reazon-research/OpenArm/(threads)

Thread 2 (2024-09-26):

Establish a policy as an OSS project

daijiro, 2024-09-26:
- 想定ユーザ
  - 研究用途〜軽作業での実用
  - 低コストで実用的な協働ロボットアームを使いたい
  - バイラテ制御を使いたい
  - テレオペで使いたい
  - 良質なデータを収集したい
  - 好きな部品を使って自由にカスタマイズしたい
- 提供機能範囲
  - バイラテラル制御
  - マルチカメラテレオペレーション
  - 7dof リーダ・フォロワアーム
  - 汎用グリッパ
  - リーダマニピュレータ
- 論点
  - リスクアセスメントどこまでやるか (ISO/TS15066)
  - バイラテを前提とするのか
  - 作業空間バイラテもやるのか
  - VRサポートするか
  - dynamixelとbrushless両方サポートするのか
  - ネットワーク帯域・遅延どこまで想定するか
  - ペイロード目標をどう設定するか
  - ROS前提とするか
  - 市販のパーツをそのまま使うかどうか

Closed 2025-02-20.

Thread 16 (2025-01-21):

CAN FD + Damiao Motors

daijiro, 2025-01-21:
The combination of CANable, CAN FD, and SocketCAN is not working properly.
When I specify `fd on`, the following message appears and the operation fails.

```sh
sudo ip link set can0 type can bitrate 1000000 fd on
RTNETLINK answers: Operation not supported
```

edwin-giang, 2025-02-27:
Closing this issue -- CANable works with DAMIAO motors

Closed 2025-02-27.

Thread 17 (2025-01-23):

Open Arm Release Updates

edwin-giang, 2025-01-23:
**Overview**
---
This issue serves as a major tracker for the development and completion of Open Arm up until the release date. The thread will continue to be updated until the first release of Open Arm.

Important Dates + Items
---
**Feb 10:** Career Fair Ship Out Date
**Feb 14:** Internal OpenArm Deadline for 1st Release
**Feb 19:** Study Group Event Date

**Major Tasks**
---
General Tasks:
- [x] ReadMe
  - Pending Edit
- [x] Landing Page
  - Pending Edit
- [x] BOM Translation
  - Merge Appendix (Pedestal) w/ Main BOM
- [x] Assembly Guide Overview
  - Waiting for Motor Assembly Steps
- [x] GitHub
  - Populate
- [x] Media Materials
  - Photos Monday, need renders
- [x] Feedback/Contact Form
  - Need hi_public@reazon.jp to update notifications
- [x] Futures Page (Things to work on next)
- [x] OpenArm Discord
  - Pending Feedback
- [x] OpenArm Pedestal Design
  - Assemble on Tuesday

@pruthakjoshi:
- [x] End Effector
  - Waiting on more parts
- [x] CAD Materials

@1lokeshpatel:
- [x] CAN FD troubleshooting
  - Create issue on GitHub
- [x] Arm Control Program
- [x] GitHub Organization

@Ravoik:
- [x] Genesis simulation control + examples
  - Create demo/tutorial
- [x] URDF validation
  - Upload final URDF version to GitHub (check w/ Edwin)

@Hiroki-HANAMORI:
- [x] Risk Assessment Guideline
- [x] Media Materials (Key Visual)
- [x] Licensing

Closed 2025-02-21.

Thread 20 (2025-01-24):

Damiao Motor Driver Soldering + Troubleshoot

edwin-giang, 2025-01-24:
Issue for tracking fix for Damiao motor driver board connector. Working on testing different methods to solder CAN connector to the board to prevent shorting.

Closed 2025-02-20.

Thread 21 (2025-01-24):

Basic Arm Motor Control Example

1lokeshpatel, 2025-01-24:
**Goal**: To create a motor control example/test that can be included as part of OpenArm first release that takes URDF joint limits for all motors and moves to given pose.

Closed 2025-02-20.

Thread 26 (2025-01-24):

BOM Clean Up

edwin-giang, 2025-01-24:
Issue for BOM/Purchasing List regarding OpenArm V1

Closed 2025-02-20.

Thread 31 (2025-01-27):

1st Release Lessons Learned Items

edwin-giang, 2025-01-27:
Thread for tracking items for improvement post 1st release OpenArm

edwin-giang, 2025-02-19:
Wire Harness Fixes
---
- Replace all harnesses that use alternative routing methods
- Universalize connector manufacturing process (same length, same input/output, solder to top/side of pin, hot glue)
- Fix 3D printed parts to route parts with interference
- Path plan wire harness for modified mechanical parts

edwin-giang, 2025-02-19:
Mechanical Fixes
---
- Make left arm components
- Fix joint limits for left arm assembly
- Reinforce wrist to EE attachment strategy
- Change EE (make non-ARX)
- Make wrist smaller (?)

edwin-giang, 2025-02-19:
Software
---
- Gravity compensation direction
- CAN FD

edwin-giang, 2025-02-25:
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

Closed 2025-02-20.

Thread 34 (2025-02-03):

Maximize Control Frequency

daijiro, 2025-02-03:
One of the key performance indicators for a robotic arm is its control frequency.
The higher the control frequency, the more accurately you can estimate the reaction force on the robot arm by comparing each motor’s current value and encoder value against the dynamics model.
This is not only important for balancing operability and reproducibility in bilateral control,
but also essential for ensuring that the robot arm can perform tasks robustly and safely in systems with significant disturbances.

The ALOHA robot arm, which uses Dynamixel motors, can be controlled at a frequency of around 500Hz.

In the document 固件更新日志-3.0.pdf (Firmware Update Log) for the Damiao motors used in OpenArm, there is a statement as follows:

    According to actual measurements, it is possible to efficiently control nine motors at 5Mbps at a control frequency of 1kHz, with no observed frame loss.

Because of this, we have been aiming for operation via CAN FD, which supports 5Mbps communication.

By using the CAN FD Extended HAT for Raspberry Pi, we confirmed that the system works with socketcan + CAN FD.
Furthermore, by updating the baudrate parameter in the motor firmware, I confirmed operation with a dbitrate set to 5M.
(However, because the motor flash memory has a limited number of rewrites, frequent parameter updates should be avoided.)
https://github.com/reazon-research/triad/blob/master/x/202501-socketcan/change_baudrate.py

However, I found that simply raising the dbitrate from 1M to 5M does not improve the control frequency.
One possible reason is that the payload length for communication messages remains 8 bytes for both sending and receiving,
so merely increasing the dbitrate may not have any effect.

The 固件更新日志-3.0.pdf describes a “one control four” mode that controls four motors simultaneously with a single message, but I was unable to confirm its operation.
(Maybe v41 firmware are not provided yet?)

Currently, our seven-axis arm can only achieve a control frequency of about 250Hz, which is inferior to ALOHA.

I implemented a simple hack to increase the control frequency without using CAN FD’s features.
Right now, we repeatedly transmit and receive data for each individual motor like this,

```python
        for motor in follower.motors:
            follower.control.controlMIT2(motor, Kp, Kd, pos, vel, tau)
            follower.control.recv()
```

I changed this to send control messages to all motors, then subsequently receive the return values from all motors like this.

```python
        for motor in follower.motors:
            follower.control.controlMIT2(motor, Kp, Kd, pos, vel, tau)
        for motor in follower.motors:
            follower.control.recv()
```

This alone increased the control frequency from 250Hz to about 450Hz. However, it is merely a workaround.

Ultimately, we want to achieve a control frequency of 1kHz.

edwin-giang, 2025-02-27:
Waiting ESP32 to arrive 03-04 -- 03-07

edwin-giang, 2025-02-28:
ESP32 arrived today -- will reopen investigation

1lokeshpatel, 2025-03-05:
received mini CAN module, will attempt to run OpenArm using m5stack mini CAN and m5stack AtomS3

1lokeshpatel, 2025-03-06:
## 03/06 Update

- Did initial test of AtomS3 and currently testing example code to connect mini CAN module with AtomS3
-  Future implementation seems like it will require replacing SocketCAN interface with MCP2517FD interface (or something similar, need to do more research), and then I will be able to test mini CAN module with OpenArm

1lokeshpatel, 2025-03-18:
## 03/18 Update

STM32 DAMIAO development board arrived yesterday. Started development with it.

**Current Progress:**
- DAMIAO uses the Keil tools developed by ARM for their dev examples so I started by setting that up. Keil is a set of development tools that includes compilers, debuggers, IDE (uVision), and more to help with embedded systems development.
- After setting up Keil and uVision (Keil development IDE), I cloned a DAMIAO example (https://github.com/dmBots/DM_Stm32_Example/tree/main/CtrlBoard-H7_4310), for controlling one motor at baudrate of 1 Mbps.
- Right now the [canfd branch](https://github.com/reazon-research/OpenArm/tree/canfd) for the OpenArm repo has code that controls one DM4310 motor. I am working on a openarm control library that controls multiple motors and will follow up on the results of that test.

edwin-giang, 2025-03-21:
Moving issue to vFuture

1lokeshpatel, 2025-03-25:
03/25 Update
---

Currently have a version of STM32 Motor Control working that controls all 7 motors. Now I want to add safety checks, add 8th end effector motor and start testing with OpenArm afterwards.

**Blockers:** The NUCLEO-F446RE board I was using as a ST-Link debugger is shorted so I need to buy a new board from the nearby stores to continue debugging and testing with DAMIAO development board.

edwin-giang, 2025-04-04:
Moving issue to v1.0

1lokeshpatel, 2025-04-10:
04/10 Update
---

**Main updates:**
- 7 motor maximum control frequency with 1MBps CAN communication with STM32 determined to be approximately 1kHz. With this control frequency, I was able to send movement commands to all motors and recieve a feedback message without any collisions and faults.
- Created a program that slowly increased torque and used it to collect data and create loop number vs velocity plot to show smooth increase in velocity.

1lokeshpatel, 2025-04-11:
04/11 Update
---
- Added velocity, position, and torque limits for DM4340 motor.
- Tested control frequency. Approximate maximum control frequency with 1Mbps STM32 control for:
  - 6 motors: 1.175kHz
  - 7 motors: 1kHz
  - 8 motors: 950Hz

Measurement metric for control frequency was to ensure that control and feedback messages were sent back and forth alternately. (if too many control messages were sent before feedback message was recieved, it would be considered too fast). Also, if the control loop timed out, that was also an indicator for a control speed that was too fast.

Seems like increasing motors does result a lower control frequency. NOTE FOR FUTURE: could be worth implementing a synchronization method for control and feedback loop to ensure that they always occur alternately, leading to more accurate control loop measurement.

Future:
- Change baudrate of motors to 5Mbps and test control frequency
- Clean up code and add safety limits
- Create commented code and detailed documentation

1lokeshpatel, 2025-04-15:
**04/15 Update**
---
- Changed all motors to 5 Mbps baudrate
- Max control frequency for 8 motors is approximately 2kHz with 5Mbps control

Same measurement metric, checking for 8 feedback messages every control loop and if there are less or if the loop timeouts, than I am assuming the control loop is running too fast.

Future:
- Update feedback messages to work with all IDs
- Currently using python script to change baudrate, working on changing baudrate using C function through STM
- Documenting progess

thomasonzhou, 2025-05-08:
CANFD STM32 code merged to main in v0.3, closing

Closed 2025-05-08.

Thread 35 (2025-02-05):

Gravity Compensation in OpenArm

hisashi-ito, 2025-02-05:
###  Motivation
OpenArm のURDFを利用することで[kdl](https://wiki.ros.org/kdl)を使って重力補償に必要な各軸のトルクが計算できる。このトルクをgenesis上でOpenArmの各軸に入力したときに、任意のポーズで静止できるかチェックする。

By using the OpenArm URDF, it is possible to calculate the torque required for gravity compensation on each axis using [kdl](https://wiki.ros.org/kdl). When this torque is input to the OpenArm axes on Genesis, it can be checked whether the arm can remain stationary in a given pose.

Closed 2025-07-23.

Thread 36 (2025-02-06):

Fork fusion2urdf to generate ros2-friendly urdf packages

thomasonzhou, 2025-02-06:
[https://github.com/syuntoku14/fusion2urdf](https://github.com/syuntoku14/fusion2urdf)
MIT license

Currently, some components are outdated:
- ALL launch files
- generated urdf (e.g. robot tag is missing name property)
- output *.obj instead of *.stl meshes

Closed 2025-02-25.

Thread 41 (2025-02-21):

Post v0.01 Release -- Electronics

edwin-giang, 2025-02-21:
Action Items for electronics improvement post release v0.1

edwin-giang, 2025-02-21:
Post v0.1 Release Action Items
---
- Add wire harness space under 3D printed covers
- Hide more wire harnesses (2 exposed max)
- Redesign w/ new connector locations in mind
- Respec cable and connectors (w/ solder joints)

Thread 42 (2025-02-21):

OpenArm Pedestal Improvements

edwin-giang, 2025-02-21:
Action Items for pedestal improvement post v0.1 release

edwin-giang, 2025-02-21:
Post v0.1 Release Action Items
---
- Change arm adapter CNC piece to M6
- Reduce shoulder width
- Increase height of pedestal by 50mm (to accommodate inspire hand) or can reduce arm length
- Add 45 degree extrusion as truss support for base
- Change 2x 30x60 to 1x 60x60
- Add housing for power brick, CANable, other electronics

edwin-giang, 2025-03-05:
03/05 Update Items
---
Updated pedestal design for v0.2 according to the list highlighted above. Below is the new design and the changes that are reflected:
- Arm Joint w/ M6 Clearance Hole
- Shoulder Width reduced to 43.6cm
- Increased height by 60mm
- Added 60degree extrusion
- Changed to single 60x60 extrusion trunk piece
- Reduced size of base plate
- Added housing area for electronics
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

edwin-giang, 2025-03-05:
Purchasing
---
Recalculated BOM for pedestal, reduction in price by 13000yen
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

edwin-giang, 2025-03-06:
Purchased, waiting for parts to arrive next week for assembly

edwin-giang, 2025-03-11:
03/11
---
Parts arrived today excluding base plate. Assembled majority, waiting on base plate arriving 03/13

edwin-giang, 2025-03-18:
03/18
---
All parts arrived, pedestal fully asssembled

Closed 2025-03-18.

Thread 43 (2025-02-21):

Post v0.1 Release -- Wrist Mechanism

edwin-giang, 2025-02-21:
Actions Items for wrist mechanism improvement post v0.1 release

edwin-giang, 2025-02-21:
Post v0.1 Release Action Items
---
- Order CNC components for temporal washer
- Increase the strength of the wrist linkages
- Increase strength of wrist frame
- Evaluate whether wrist assembly needs to decrease in length or width
- Investigate other wrist designs (rotary actuator, linear actuator, pulley actuator)

Thread 44 (2025-02-21):

Post v0.1 Release -- General Items

edwin-giang, 2025-02-21:
Action items for general items post v0.1 release

edwin-giang, 2025-02-21:
Post v0.1 Release Action Items
---
- Make dedicated arm for left arm use (differentiate from right arm)
- Add power switch + E-stop
- Re-evaluate risk factors of v0.1
- Add mechanical stop for elbow mechanism
- Update website, discord, github
- Work on dedicated leader arm

Thread 45 (2025-02-21):

Post v0.1 Release -- Software Items

edwin-giang, 2025-02-21:
Action items for software improvement post v0.1 release

edwin-giang, 2025-02-21:
Post v0.1 Release Action Items
---
**Simulation + URDF:**
- Update how left + right jaw joints are defined in simulation
- Fix base position
- Generate URDF for Pedestal
- Define force actuated limits
- Define inertia and mass of joints
- Create a better URDF w/ simplified geometry and no fasteners
- Define self-collision
- Create URDF w/ 5DOF EE attachment
- Create simple script to swap in different EEs
- Create more examples for simulation (IL, RL)

**Controls:**
- Clean up unilateral + bilateral code (add to github)
- Fix gravity compensation
- Remove jitter on CAN FD
- Merge control code onto 1 PC (unite left and right arm code)
- Define MIT Control
- Create ROS2 control library

Thread 46 (2025-02-21):

URDF CAD Simplification

edwin-giang, 2025-02-21:
Working on simplify CAD to help with meshes and reduce solve time

thomasonzhou, 2025-02-26:
Defining bounding boxes with RobotCAD and using the original meshes as visual representations only should speed up our sims:

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

thomasonzhou, 2025-03-10:
The addition of the dual gripper arm urdf in [openarm_ros2](https://github.com/reazon-research/openarm_ros2) is completed, closing issue

Closed 2025-03-10.

Thread 49 (2025-02-25):

Wire Harness Improvements

edwin-giang, 2025-02-25:
**Action Items for Wire Harness Improvements:**
- [x] Hide more wire harnesses (2 exposed max) (reduced as much as was reasonable)
- [x] Measure and plan remaining harness lengths in arm
- [x] Ask @NaohiroIIDA about manufacturing and order the cables

edwin-giang, 2025-02-28:
Measured and routed wire harnessing plan. Creating drawing to plan out cable splices and lengths:
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

edwin-giang, 2025-03-05:
02/27 Updates
---
Backlogged documentation from internal discussions:
Looked into LCSC for cable manufacturing, submitted quote for spliced cable design based off below drawing

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

edwin-giang, 2025-03-05:
02/28
---
Backlogged documentation from internal discussions:
Received quote for cables, cables are $2.99 per

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

edwin-giang, 2025-03-06:
03/06
---
Tested hand-soldered cables length -- remeasured cable C and need to fix cable B to have another splice
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

edwin-giang, 2025-03-10:
03/07
---
Reordered 12 new sets of cables from LCSC electronics according to new cable length. Won't arrive for v0.2 demo, will need to make 5 sets of new cables for demo arms -- asking @necobit for assistance.

edwin-giang, 2025-03-18:
03/17
---
- Issue with JST connector breaking. Asking @NaohiroIIDA to manufacture replacement cables temporarily.
- LCSC cables C and D arrived. Assessing quality versus hand manufactured cables. Gauge is much smaller on the LCSC cables compared to hand manufactured cables, but solder joint is more robust.

edwin-giang, 2025-03-18:
03/18
---
New batch of JST connectors arrived -- some cable length is slightly short due to manufacturer error. Will reorder and respec to account for manufacture tolerance. Closing issue for v0.2

Closed 2025-03-18.

Thread 50 (2025-02-25):

OpenArm Connector Improvements

edwin-giang, 2025-02-25:
**Action Items for Connector Improvements:**
- [x] Respec cable and male connectors (w/ solder joints)
- [x] Order motors with pre-soldered female connectors

hiroyams, 2025-02-27:
Talked with Kawazu-san
Mtg: Ryan, Hanamori-san, Kawazu-san
- investigate LCSC componenets

edwin-giang, 2025-03-05:
03/05 Updates
---
Issue is partially merged with #49 -- progress with LCSC is documented there

edwin-giang, 2025-03-18:
03/17
---
Issue is colliding with #75, closing issue as duplicate.

Closed 2025-03-18.

Thread 51 (2025-02-25):

OpenArm Wrist Mechanism Improvements

edwin-giang, 2025-02-25:
**Action Items for Wrist Mechanism Improvements:**
- [x] Increase the strength of the wrist linkages (p1)
  - [x] quick eval, see if changing material is enough
- [x] Order CNC components for temporal washer
- [x] Increase strength of wrist frame

edwin-giang, 2025-03-10:
03/07
---
FEA comparison between materials by Hanamori-san:
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

Above image is Aluminum, below is SS400. Shows roughly 1/3 the deformation -- may still need part redesign since forces exerted are much larger than simulated.

edwin-giang, 2025-03-18:
03/16
---
Order for SS parts arrived and assembled onto new arm. Will evaluate strength and reassess for next version. Closing issue for v0.2.

Closed 2025-03-18.

Thread 52 (2025-02-25):

Future Wrist Mechanism Items

edwin-giang, 2025-02-25:
**Future Wrist Mechanism Action Items:**
- [ ] Evaluate whether wrist assembly needs to decrease in length or width
- [ ] Investigate other wrist designs (rotary actuator, linear actuator, pulley actuator)

Thread 53 (2025-02-25):

OpenArm End Effector Improvements

edwin-giang, 2025-02-25:
**Action Items for End Effector Improvements:**
- [x] Reconduct risk assessment for the wrist
- [x] Change gripper claw design
- [x] Add backdrivability to claw (less friction)

hiroyams, 2025-02-27:
low priority, minimal fix:
- safety and wrist

Ravoik, 2025-03-06:
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

Finalized for v0.2, printing to test

Ravoik, 2025-03-06:
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

edwin-giang, 2025-03-18:
03/17
---
Breaking leader controller into separate sub-issue. For backdrivability, increased tolerance between bridge and rail -- using silicone spray to reduce friction of parts. End effector redesign is complete for v0.2, closing issue.

Closed 2025-03-18.

Thread 55 (2025-02-25):

OpenArm Simulation + URDF Improvements

edwin-giang, 2025-02-25:
**Action Items for Sim + URDF Improvements:**
- [x] Generate URDF for Pedestal 2.0
- [x] Create a better URDF w/ simplified geometry and no fasteners
- [x] Update how left + right jaw joints are defined in simulation
- [x] Fix base position
- [x] Edwin creating rigid groups in CAD with bodies to simplify geometry and export unified meshes for joints.
- [x] Once rigid groups are done we need to make a LHS flipped version of the arm to generate a urdf
- [x] need to swap the base of the open arm in cad to the pedestal base so that the urdfs can properly merge on the software side

1lokeshpatel, 2025-02-25:
URDF R/L Joint DOF Comparison:

- **joint 1**: same
- **joint 2**: mirror
- **joint 3**: mirror
- **joint 4**: same
- **joint 5**: mirror
- **joint 6**: same
- **joint 7**: mirror

edwin-giang, 2025-03-05:
03/05 Updates
---
- Generated URDF + mesh for pedestal
- Simplified URDF w/o fasteners, no rack on jaw joints
- Used RobotCAD to make conservative blocks for collision
- Used mimic to link left and right jaw

edwin-giang, 2025-03-05:
Need to merge pedestal v0.2 mesh and openarm mesh

Ravoik, 2025-03-05:
Edwin creating rigid groups in CAD with bodies to simplify geometry and export unified meshes for joints.

edwin-giang, 2025-03-06:
Waiting on left arm CAD from @Hiroki-HANAMORI before creating URDF export version

edwin-giang, 2025-03-10:
03/08
---
Created left arm CAD based off the assembly given by Hanamori-san. Closing issue since all CAD improvements for URDF v0.2 are completed

Closed 2025-03-10.

Thread 56 (2025-02-25):

OpenArm Controls Improvements

edwin-giang, 2025-02-25:
**Action Items for Controls Improvements:**
- [x] Merge control code onto 1 PC (unite left and right arm code)

edwin-giang, 2025-03-18:
03/18
---
Not merging until we receive new STM with more ports (current setup does not have enough ports for both arms)

edwin-giang, 2025-03-21:
Moving issue to vFuture

edwin-giang, 2025-04-04:
Closing issue under v1.0, teleop control code merged into one device

Closed 2025-04-04.

Thread 58 (2025-02-25):

OpenArm Safety Improvements

edwin-giang, 2025-02-25:
**Action Items for OpenArm Safety Improvements:**
- [ ] Add **power switch** and add to BOM-- HIGH PRIORITY
- [x] Re-evaluate risk factors of v0.1

edwin-giang, 2025-03-21:
Moving issue to vFuture

Closed 2025-07-23.

Thread 59 (2025-02-25):

Left Arm Design

edwin-giang, 2025-02-25:
**Action Items:**
- [x] Adapt mechanical design for left OpenArm

Ravoik, 2025-03-05:
- Ordered some flipped parts for Open Arm left arm
- @Hiroki-HANAMORI need to discuss the shoulder joint parts, need to flip and order LHS versions of these parts because the limits are different from the right.

edwin-giang, 2025-03-06:
03/06
---
Determined plan to create left and right arm using mainly pre-existing parts. Left arm joint 2 will have bearing located at front, right arm will have bearing at back. For both arms, follow the guide below for assembly:
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

edwin-giang, 2025-04-04:
03/19
---
Completed reassembly of OpenArm for left arm. Ordered mirrored sheet metal parts for left wrist and assembled. Closing issue under v0.2, will iterate in future versions

Closed 2025-04-04.

Thread 61 (2025-02-26):

Specification Sheet

edwin-giang, 2025-02-26:
**Action Items:**
- [x] Measure Capacity of OpenArm
- [x] Create spec sheet to put on the website

hiroyams, 2025-02-27:
list out what specs we want to measure, consider work load

edwin-giang, 2025-03-21:
Moving to vFuture, unblocking issue

edwin-giang, 2025-04-04:
closing issue under v0.2, spec sheet on github and website

Closed 2025-04-04.

Thread 62 (2025-02-27):

Redesign OpenArm

hiroyams, 2025-02-27:
- [ ] consider cabling (camera, hand, sensors, etc.)

Closed 2025-07-23.

Thread 63 (2025-02-28):

Strengthen wrist to hand attachment method

edwin-giang, 2025-02-28:
Strengthening linkage for end effector to arm attachment

edwin-giang, 2025-02-28:
Assigned Lokesh to issue

1lokeshpatel, 2025-02-28:
finished first draft of design, located in Fusion360. ReazonResearch --> Triad --> Data_by_LOKESH --> EndEffector_WristRedesign

**Changes to make:**
- add counter sink for screws into motor (reducing size of that plate
- shorten link as much as possible

1lokeshpatel, 2025-03-05:
## 03/05 Update

- added countersunk holes for both plates
- added fillets to smoothen design
- reduced plate size and link length size
- changed to cap design instead of small juts for hardstop

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

1lokeshpatel, 2025-03-06:
## 03/06 Update

- Printed first design

**Issues:**
- the 4th attachment hole for end effector motor cannot be blocked by linkage as it is needed to strengthen and ensure it doesn't snap
- slight tolerancing changes needed for countersinks and cap design to ensure there are no collisions with fasteners
- more feature fillets

**Fixes:**
- create the feature fillets
- widen the linkage as much as possible and create fillets where possible for stress distribution

1lokeshpatel, 2025-03-10:
## 03/10 Update

Tested with feature fillets and 4th hole addition. Works okay but need larger opening for that screw to be inserted in a more smooth manner. Also printing in a different orientation helps with overall print quality.

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

**Changes:**
- larger opening for that screw hole, increase overall diameter of pipe extrude cut but also expand horizontally out of the plate.

1lokeshpatel, 2025-03-11:
**Final Iteration, will reopen if testing reveals flaws:**

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

Closed 2025-03-11.

Thread 64 (2025-02-28):

Define inertia and mass of joints

edwin-giang, 2025-02-28:
Physical testing of inertia and mass of joints

edwin-giang, 2025-03-04:
03/04 Meeting:
---
- Currently testing one arm for inertia values
  - Had issue with baudrate, now reset so testing can continue

thomasonzhou, 2025-03-04:
Test code available at: https://github.com/reazon-research/inertia-test
The baud rate update python script is reset after power cycling, so we should opt to flash permanently when possible (@1lokeshpatel do we have another open issue already?)

edwin-giang, 2025-03-06:
Waiting to test 4340P motors, blocked since motors have not been assembled -- devising new test plan

edwin-giang, 2025-03-11:
03/11
---
Opened issue #78 for 4340P motors, closing this issue now as all inertia testing for 4340 is complete.

thomasonzhou, 2025-03-12:
Masses (kg)
1. 0.486
2. 0.178
3. 0.404
4. 1.123
5. 0.558
6. 0.470
7. 0.346
8. 0.298

*Link 1 did not include the the mounting components:

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

Closed 2025-03-11.

Thread 65 (2025-02-28):

Motor Connector Soldering

edwin-giang, 2025-02-28:
Hotfix connectors by soldering 2x male connectors to each DAMIAO motor

edwin-giang, 2025-02-28:
Disassembling arm -- breaking into major linkages for Inertia Testing #64.
Noting down loose fasteners from demo day use.

Ravoik, 2025-02-28:
Lose Fasteners
--------------------
- Top four 30x60 nuts were pretty loose, did not need to use long side of m4 Allen key to remove them which is troubling because they were tightened with the long side. Hopefully resolved by using m6 nuts in the future.
- Horizontal Wrist Motor, 4 face mount screws loose enough to jiggle the entire motor.

Connector Soldering Updates
-------------------
- Unscrewed all caps
- Desoldered old leads
- Cleaned solder pads
- Unscrewed pcbs

edwin-giang, 2025-03-05:
03/05 Updates
---
Soldering new connectors for both arms complete
- Soldered 2 male CAN connectors to each motor
- Assembling arms back together

Ravoik, 2025-03-05:
- Arms reassembled, waiting on cables to power them on (eta minimum Thursday)

Closed 2025-03-05.

Thread 67 (2025-03-05):

Create URDF w/ EE attachment

edwin-giang, 2025-03-05:
Create method to attach different end effectors for URDF MuJuCo file
- For inspire hand, need to retain joint activation in URDF

thomasonzhou, 2025-03-17:
URDFs for openarm and openarm_bilateral are complete, closing

Closed 2025-03-17.

Thread 70 (2025-03-05):

Threadlocker/Screws loosening

Ravoik, 2025-03-05:
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

 _Originally posted by @Ravoik in [#65](https://github.com/reazon-research/OpenArm/issues/65#issuecomment-2689659791)_

edwin-giang, 2025-03-11:
03/11
---
Closing issue since key loctite locations have been identified

Closed 2025-03-11.

Thread 71 (2025-03-05):

Create Base plate for Inspire hand

Ravoik, 2025-03-05:
Create a 3d printable base-plate to mount the inspire hand to a table

edwin-giang, 2025-03-10:
03/07
---
Simple 3D printed base was created by tracker team, closing issue.

Ravoik, 2025-03-11:
@megan-spee if you could upload the file here please 🙏

edwin-giang, 2025-03-19:
03/19
---
Linking part files for inspire hand base:
[hand_mount.zip](https://github.com/user-attachments/files/19331872/hand_mount.zip)

Closing issue

Closed 2025-03-19.

Thread 72 (2025-03-05):

Build 2 more arms and add locktite to all arms

Ravoik, 2025-03-05:
Set up a meeting with Hanamori-san to figure out where the locktite will go
- [ ] assemble left arm
- [ ] assemble right arm
- [ ] locktite all arms

Ravoik, 2025-03-11:
Finished all motor cap replacements together on 3/10, edwin has been assembling and is 50% done both arms as of 3/11.
Made the decision to make two left arms instead of a left and right.

edwin-giang, 2025-03-11:
03/11
---
85% of arm is assembled, waiting on new wrist machined components to finish assembly.

edwin-giang, 2025-03-18:
03/17
---
Completed new arm assembly, ready to be mounted to pedestal

Thread 73 (2025-03-06):

investigate & compare motors

edwin-giang, 2025-03-06:

edwin-giang, 2025-03-06:
03/06 Updates
---
Conducted brief comparison and breakdown of specs of each motor
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

Inquired about purchasing, will create a PO later today to purchase and test motors

edwin-giang, 2025-04-04:
03/27
---

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

Compared wider variety of motors across greater ranges, purchased 8009 for investigation

Thread 75 (2025-03-06):

Redesign cover cutout locations with respect to new connector locations

edwin-giang, 2025-03-06:

edwin-giang, 2025-03-06:
03/06
---
Need to delegate who owns this issue

edwin-giang, 2025-03-11:
03/11
---
Designed new cover cutouts, printing to test

edwin-giang, 2025-03-18:
03/17
---
Redesign of cover cutouts complete for v0.2. Closing issue.

Closed 2025-03-18.

Thread 76 (2025-03-06):

Define MIT Control

edwin-giang, 2025-03-06:

edwin-giang, 2025-03-06:
Moved issue to vFuture

thomasonzhou, 2025-03-06:
Manual from the supplier: [MIT instructions (chinese).pdf](https://github.com/user-attachments/files/19101282/MIT.instructions.chinese.pdf)

Closed 2025-03-06.

Thread 77 (2025-03-06):

Create ROS2 control library

edwin-giang, 2025-03-06:

edwin-giang, 2025-03-06:
Moved issue to vFuture

thomasonzhou, 2025-03-06:
WIP on ros2_control branch:
https://github.com/reazon-research/openarm_ros2/tree/ros2_control

Subtasks:
- [x] define control interfaces
- [  ] complete hardware package (start with position control, then velocity, torque)
- [  ] create simple controller (PID)
- [  ] complete bringup package (1 command launch)

edwin-giang, 2025-04-04:
moving issue to v1.0

edwin-giang, 2025-04-10:
Video of ROS2 Control implementation

https://github.com/user-attachments/assets/f9a173ba-f2f1-4ecc-b61e-a9716bf19885

thomasonzhou, 2025-04-10:
Merged to main https://github.com/reazon-research/openarm_ros2/tree/main

Requesting a commit bump in the main repo @edwin-giang
- https://github.com/reazon-research/OpenArm/pull/92

Closed 2025-04-24.

Thread 78 (2025-03-06):

4340P CAD and URDF Adjustments

Ravoik, 2025-03-06:
We need to adjust the CAD caps that interface with the 4340P as well as re-measure the inertia values for the effected axis.
- [ ] 4340P CAD modified
- [ ] 4340P parts ordered
- [ ] 4340P mounted on arm and inertia measured

Hiroki-HANAMORI, 2025-03-14:
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
CAD updates have been completed to accommodate 4340P.
The general shape of the arm has changed little.

Left side of image: old arm
Right side of the image: arm with 4340P installed

Hiroki-HANAMORI, 2025-03-14:
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

The cross roller version of the DAMIAO gear head has been modified to a structure that holds the bearings in place.
Therefore, it was modified so that the cap for attaching the key can be assembled without disassembling.

J1 has already been assembled with Ory-san's arm, so no change is necessary.
J3 was modified to install the gear head without disassembling the gear head, reflecting the reflection on Ory-san's arm.

Hiroki-HANAMORI, 2025-03-14:
Preparation of order data has begun.
Inquiries are underway for J3 caps due to a processing error.

To avoid errors in the quotation, I am also preparing data with the error points removed, but this will reduce the strength of the part.
If the quotation takes time, we will proceed with the order.

edwin-giang, 2025-04-04:
04/03
---
Moving issue to v1.0. New parts for 4340P arrived and reassembly was completed. Will adjust and reorder parts as needed

Hiroki-HANAMORI, 2025-04-04:
Details of any problems identified in assembly and plans for revision

- Axis parts for symmetrical parts, length needs to be extended by 1,mm.
-- Perhaps the fact that the 4310 was made from the CAD of the 4340 had a negative effect.
-- Despite the different thickness of the TOP caps of 4340 and 4310, they were designed with the same dimensions, which caused the axis to sink 1mm...
-- In this case, we used a 1mm spacer
- The shaft part coming out of J1 needs to be extended by 3mm in length.
-- Purely an ordering error.
-- The old data was submitted.
-- This time, we used a 3mm spacer.
- Connector position of 4340P is not very good.
-- The connector position was subtle because the original hole on the top surface of the motor was used.
-- The base part could be handled by changing the slit position.
-- J3 may have to allow the connector to be tilted.

Thread 79 (2025-03-06):

Confirm rigid group URDF generation works in Onshape

Ravoik, 2025-03-06:
We have a rigid group assembly of our components in Fusion working and exporting to URDF & robotcad.
We need to check if this method works in Onshape because Fusion license will end by 03/10

edwin-giang, 2025-03-19:
03/19
---
Moving issue to vFuture

Closed 2025-07-23.

Thread 80 (2025-03-06):

Improvements to make the arm symmetrical

Hiroki-HANAMORI, 2025-03-06:
In order to position the arm in a humanoid shape, it is necessary to invert the assembly and invert the parts.

- [ ] Parts Mirror
- [ ] Adjustment of machine limits
- [ ] Mirroring of assemblies
- [ ] Adjustment of URDF

Closed 2025-03-06.

Thread 81 (2025-03-07):

Autocalibration on Startup

thomasonzhou, 2025-03-07:
There is currently a gap between CAD/URDF/MJCF joint parameters and the real joint parameters on real robots, namely:
- joint limits
- zero positions

To add an additional layer of reliability on top of the mechanical hard stops, it would make sense to add software stops. One way to do this would involve:
1. detecting the true joint limits on startup (gently move position command to ends until it does not change)
2. moving to a known offset (desired zero position)
3. set zero positions of motors

edwin-giang, 2025-03-18:
Moving to vFuture

edwin-giang, 2025-04-04:
Assigning issue to @Ravoik, moving issue to v1.0

Ravoik, 2025-04-14:
Measured joint limits and necessary offsets, converting to rads.
Figured out MIT control and how to use the library.
Wired spare open arm, setup with pedestal.
Finished 1st version of script, need to clean up and comment on code. Will post a video here.

Thread 82 (2025-03-18):

Redesign leader controller

edwin-giang, 2025-03-18:
Make minor adjustments to leader controller
- [x] fix grip shape and distance
- [ ] change pincher shape

edwin-giang, 2025-03-19:
03/19
---
Updated leader controller design, printing to test
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

edwin-giang, 2025-03-21:
03/19
---
Printed and tested, demoed for v0.2. Will work on reiterating design for next version. Moving issue to vFuture

edwin-giang, 2025-04-04:
moving issue to v1.0, need to adjust pinching mechanism

edwin-giang, 2025-04-18:
04/18
---
Updated Leader Controller design. Designed with the following criteria in mind:
- Improve ease of actuation
- Increase backdrivability
- Improve safety conditions from potential of rail or end effector components hitting user
- Design for machined components and 3D printed components

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

Printed and tested using heat set inserts, closing issue for this version

Closed 2025-04-18.

Thread 86 (2025-04-04):

Add mechanical stop for elbow mechanism

edwin-giang, 2025-04-04:
- [ ] Redesigning machined component to redefine ROM of elbow joint

edwin-giang, 2025-04-04:
Broke out issue from #58, assign self to task, moving to v1.0

edwin-giang, 2025-04-04:
04/04
---
Adjusted mechanical joint limit of elbow, reduced flexion by 10 degrees to avoid upperarm and forearm pinching condition that occurs when wrist is rotated. Reduced extension by 20 degrees to avoid elbow inversion condition.

Closed 2025-04-24.

Thread 87 (2025-04-04):

Payload Testing

edwin-giang, 2025-04-04:
*What is the pre-existing problem? Please describe.*
Need to properly evaluate payload capacity of OpenArm for spec sheet and future planning

*Describe the solution you'd like*
Testing increasing weights under standards conditions and worst case conditions

*Additional context*
End effector included in test. Using water weight.

*Next Steps*
- [ ] Conduct Payload Test

edwin-giang, 2025-04-04:
03/27
---
From 03/27, payload testing conducted and completed. Testing different ranges of weight using filled water bottle.

At standard payload (regular workspace), arms were capable of handling up to ~3kg not including the end effector. Arm did not trigger safety mechanism despite this load.

At worst case payload (furthest from COG), arms were capable of handling 1.6kg not including the end effector. Arm triggered safety mechanism at max reach point under this load.

Calculations were conducted to verify payload results. Screenshots are depicted below verifying results:

_For Worst Case:_
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
DAMIAO 4340 has a max torque of 27Nm -- matches the result from test

_For Standard Case:_
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
For standard case, calculations show arm is capable of 5.5kg payload. Since this was not tested in the payload, a conservative estimate of 3.5kg was used.

Closed 2025-04-04.

Thread 88 (2025-04-04):

Improved disassembly procedure for DAMIAO motors

Hiroki-HANAMORI, 2025-04-04:
Disassembly of DAMIAO motors, especially the removal of the 4340 BTM capsule, is difficult because thread lock is applied to the M2 countersunk screws, which sometimes destroys the threaded holes during disassembly.
Considering that users can assemble them or outsource mass production to outside companies, a stable method of disassembly should be considered.

There are several possible methods for the disassembly. Each method will be verified and the recommended procedure will be determined for this project.
Once the procedure is determined, the details will be described in a document.

1. Tool method
Remove the screws using the appropriate tool.
This will also be considered as a remedy in case the screw removal fails and the screw hole is destroyed.

2. Thermal method
A method of softening thread lock by heat.

3. Chemical method
A method of removing thread lock using chemicals such as gasket remover.

Hiroki-HANAMORI, 2025-04-04:
Discussion of tool methods:
Screw removers were an effective method of rescuing destroyed screws.
For stable rescue,
equipment that could be raised and lowered vertically, like a drilling machine, was needed.

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

Hiroki-HANAMORI, 2025-04-04:
Discussion of tool methods:
We tried BONDHUS hexagonal wrenches, which are larger in size than regular hexagonal wrenches and have no clearance, making it easier to transmit force.
**The result was failure.**
It destroyed the threaded hole as well as a regular hex wrench.

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

Hiroki-HANAMORI, 2025-04-04:
Consideration of thermal methods:
Heat may be able to soften thread lock by, for example, placing the BTM cap down on a hot plate.
However, considering that the motor driver is attached to the BTM side and the frame is heatsinked to dissipate heat to the FETs, the heat may adversely affect the circuitry.

**Therefore, it is best to avoid this approach.**

Hiroki-HANAMORI, 2025-04-04:
Consideration of chemical methods:
Gasket remover or other means may be used to soften the thread lock.
However, given the depth of the threads and the amount of thread lock, it is difficult to believe that this would be an effective method.

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

Hiroki-HANAMORI, 2025-04-04:
Consideration of tool methods:
During assembly, I tried a T6 Torx wrench, which worked very well.
The success was probably due to the fact that the protrusion of the Torx wrench, which is designed to transmit torque firmly, bit firmly into the hole.
Even a slightly broken screw could be turned firmly.

Originally, Torx wrenches are designed to turn screws specifically for that purpose.
In this case, it is used only as an exception.

**This method should be adopted as the recommended method.**

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

Hiroki-HANAMORI, 2025-04-17:
Hand work with a Torx wrench went well at first.
However, after loosening a few screws, it seemed to go wrong.

Closed 2025-07-23.

Thread 89 (2025-04-04):

New Cable Respec

edwin-giang, 2025-04-04:
*What is the pre-existing problem? Please describe.*
Need to respec and reorder cables to work with v0.2 arms

*Describe the solution you'd like*
Order longer cables

*Next Steps*
- [ ] Order longer cables from LCSC

edwin-giang, 2025-04-04:
03/27
---
Ordered cables of longer length according to below drawing, estimated arrival 04/07

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

Thread 90 (2025-04-04):

Camera Integration w/ OpenArm

edwin-giang, 2025-04-04:
*What is the pre-existing problem? Please describe.*
Need to add a camera to OpenArm + Pedestal to collect date for RL, IL, and other training

*Describe the solution you'd like*
Mount a single realsense camera to the top of OpenArm pedestal

*Next Steps*
- [ ] Design a camera mount to attach realsense camera to pedestal

edwin-giang, 2025-04-04:
04/03
---
Updates from 03/27 to 04/03:
Designed single camera mount to attach realsense cam to openarm pedestal. Made tilt adjustable to optimize angle and FOV.
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

Using this setup to train OpenArm until 04/07, will update camera mount design afterwards and discuss if additional setup is needed

thomasonzhou, 2025-04-10:
Used in GR00T N1 initial data collection and deployment: https://github.com/reazon-research/Isaac-GR00T

Seems to be a flexible enough solution for now, closing.

Thread 91 (2025-04-04):

8009 + 8009P Investigation

edwin-giang, 2025-04-04:
*What is the pre-existing problem? Please describe.*
Will OpenArm need to increase its payload capacity for the future in order to achieve research targets?

*Describe the solution you'd like*
Investigate other motor alternatives, determine whether they would be good to integrate into OpenArm.

*Next Steps*
- [ ] Conduct Payload Testing
- [ ] Determine Motor Candidates that meet payload requirements
- [ ] Order motor candidates
- [ ] test and validate for OpenArm

edwin-giang, 2025-04-04:
04/04
---
Updates from 03/27 until 04/04:
Conducted payload test to determine openarm capacity #87. For current application is sufficient for basic models but will need larger capacity in the future for larger end effector support.

To support larger end effectors (~1kg) and still grasp sufficient weight, a total of 3.5kg payload including end effector is required for worst case scenario. This requires a max torque capacity of 40Nm from motor 1. 5.5kg is still sufficient for standard payload. The below SS shows the calculations support this value:

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

The following motors were then scouted to determine potential candidates:

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

From these candidates, the 8009 and 8009P were ordered due to their torque range, compatibility with existing DAMIAO architecture, and price point. Currently working on procurement of motors.

Thread 93 (2025-04-10):

MuJoCo hardware_interface for ROS2

thomasonzhou, 2025-04-10:
Adding a hardware interface representing OpenArm in MuJoCo allows for control with arbitrary inputs (physical leader arms, tracked human pose, etc.)

ROS2 control interface plugin that can be hot swapped for the current openarm_hardware interface

This seems to be a good starting point: https://github.com/moveit/mujoco_ros2_control

thomasonzhou, 2025-04-24:
Investigated https://github.com/ubi-agni/mujoco_ros_pkgs, seems to be a promising solution so moving forward with this.

Thread 96 (2025-04-15):

April Meeting Minutes

edwin-giang, 2025-04-15:
April Meeting Minute Documentation

edwin-giang, 2025-04-15:
04/15 RD Meeting Minutes:
---
- RT Meeting:
  - Updated RT on feedback from US
  - got manufacturing feedback from RT
  - shared timeline for openarm
  - do beta release before v1.0
  - will take responsibility for manufacturing + shipping
  - can do shipping overseas
  - RT will take responsibility for custom pieces
- Edwin:
  - Covers
  - Leader Controller
- Ryan:
  - Getting motors
  - Auto-calibration
- Lokesh
  - tested control frequency for 1Mbps (6-8 motors)
    - 6 motor control frequency -- 1.175kHz
    - 7 motor control frequency -- 1kHz
    - 8 motor control frequency -- 900Hz
  - Changed to 5Mbps
  - Changed STM32 code to run at 5Mbps
    - 8 motor control frequency -- 1.6kHz
  - Added save motor param for baud rate -- permanently sets baudrate
  - Planning to add synchronization
  - Will document and onboard Toki-san on STM control
- Hanamori:
  - Shortened length of forearm
  - Adjusted limit of elbow
  - Will arrive 04/21
  - Updated risk assessment guideline
  - Need to update BOM
  - Need to record dimension of cables, where to purchase, installation
- Other Items:
  - OSS Project (Pollen)

edwin-giang, 2025-04-17:
04/17 Meeting Minutes
---
Ryan:
- DM8009P Motors Arrived
  - No 8009 motors :(
- Unified and commented on calibration script code

Toki:
- Setting motor IDs and verifying the motor firmware
- Testing bilateral feedback on 5Mbps using STM32

Edwin:
- Updated leader controller
- updating covers

Lokesh:
- Improving STM32 library functionality (by Friday)

Thomason:
- MoveIt pick and place is priority
- Mujoco can be done remotely, will be deprioritized

Hanamori:
- Assemble 8009P motors into openarm

Iida:
- Making cables for 8009P motors
- Testing 48V AC adapter using load tester

Pruthak:
- Doing research for next phase of openarm
  - Moving base, other items
- Working on assembly manual, auxiliary items
- Will work with hanamori-san to assemble arms

hiroyams, 2025-04-24:
# OpenArm v0.3 Feedback
## Other
- move important logs in issues to main doc
  - links to all files + documentation per subproject
- Safety doc
## Hardware

### In Progress
- 8009 accommodation
  - eval of 8009
  - redoing harnessing
- Safety TPU covers
- Linear EE
  - make some 3D printed parts to be machined
- LCSC connectors are mid
  - documentation: still in issue
  - [ ] see other connectors from LCSC
  - [ ] investigate other supplier
- Torque testor
  - MyActuator
  - RoboStride
  - WinTech
- Static discharge investigation
- Camera mounting options
- Wrist design
  - Inspire-hand mount
- Disassembly Procedure for DAMIAO
  - want to fix before moving to production w RT
### Future
- Wrist redesign
- Simplified and unified manufacturing
  - hardware stop

## Controls
### In Progress
- [ ] Toki-san catchup w/ Thomason and Ishida-san
- STM32
- MuJoCo to ROS2 control integration
- URDF corrected
  - reference other humanoids, use standard direction
- Autocalibration
- Document on 5Mbps to 1Mbps (reversible) @1lokeshpatel
- ROS2 controls for gravity comp: Thomason -> Ishida
- Vanilla Teleop: Thomason -> ?
- ROS2 controls
  - safety filter (prevent large jump of values)

hiroyams, 2025-04-24:
# OpenArm v1.0

hiroyams, 2025-04-24:
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

thomasonzhou, 2025-04-24:
In Progress: Add URDF to website

Thread 99 (2025-04-24):

URDF Adjustments

thomasonzhou, 2025-04-24:
The humanoid coordinate frames and link for the robot should be adjusted to conform to https://www.ros.org/reps/rep-0120.html

For reference, some exisiting MJCF files: https://humanoids.wiki/w/Robot_Descriptions_List

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

thomasonzhou, 2025-04-24:
Subtasks:
- [ ] Change zero position to be folded for single arm (not upright)
- [ ] Investigate + document differences between common humanoid and OpenArm
- [ ] Evaluate other coordinate parameterizations:
  - Denavit-Hartenberg (current)
  - Screw Theory

Thread 103 (2025-05-07):

Friction Characteristics Identification

tokirobot, 2025-05-07:
## Friction Characteristic

Friction characteristics identified via constant velocity test.
Useful for friction compensation and improving force control.
The follwing four models were used for identification
The following four parameters are obtained by performing curve fitting on the acquired data

- **Fc**: Coulomb friction coefficient
- **k**: Slope factor for nonlinear transition
- **Fv**: Viscous friction coefficient
- **Fo**: Constant offset

$$
F(v) = F_v v + F_o
$$

$$
F(v) = F_c \cdot \arctan(k v) + F_v v + F_o
$$

$$
F(v) = F_c \cdot \tanh(k v) + F_v v + F_o
$$

$$
F(v) = F_c \left( \frac{2}{1 + e^{-k v}} - 1 \right) + F_v v + F_o
$$

tokirobot, 2025-05-07:
## each joint result

## 1 axis
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

| Model      | Fc      | k            | Fv     | Fo     | Note              |
|------------|---------|--------------|--------|--------|-------------------|
| Linear (+) | —       | —            | 0.562  | 0.560  | Positive velocity |
| Linear (−) | —       | —            | 0.482  | -0.584 | Negative velocity |
| atan       | 0.364   | 245321638.315| 0.522  | 0.012  | —                 |
| tanh       | 0.572   | 193.814      | 0.522  | 0.012  | —                 |
| sigmoid    | 0.572   | 454.567      | 0.522  | 0.012  | —                 |

## 2 axis

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

| Model      | Fc     | k      | Fv     | Fo     | Note              |
|------------|--------|--------|--------|--------|-------------------|
| Linear (+) | —      | —      | 0.443  | 0.447  | Positive velocity |
| Linear (−) | —      | —      | 0.459  | -0.388 | Negative velocity |
| atan       | 0.289  | 57.541 | 0.415  | 0.025  | —                 |
| tanh       | 0.426  | 22.227 | 0.440  | 0.025  | —                 |
| sigmoid    | 0.426  | 44.453 | 0.440  | 0.025  | —                 |

## 3 axis

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
| Model      | Fc     | k      | Fv     | Fo     | Note              |
|------------|--------|--------|--------|--------|-------------------|
| Linear (+) | —      | —      | 0.585  | 0.469  | Positive velocity |
| Linear (−) | —      | —      | 0.633  | -0.423 | Negative velocity |
| atan       | 0.300  | 95.563 | 0.585  | 0.008  | —                 |
| tanh       | 0.450  | 29.065 | 0.604  | 0.008  | —                 |
| sigmoid    | 0.450  | 58.130 | 0.604  | 0.008  | —                 |

## 4 axis

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

| Model      | Fc     | k            | Fv     | Fo     | Note              |
|------------|--------|--------------|--------|--------|-------------------|
| Linear (+) | —      | —            | 0.753  | 0.125  | Positive velocity |
| Linear (−) | —      | —            | 0.875  | -0.166 | Negative velocity |
| atan       | 0.093  | 67917138.035 | 0.813  | -0.058 | —                 |
| tanh       | 0.146  | 130.038      | 0.813  | -0.058 | —                 |
| sigmoid    | 0.146  | 343.957      | 0.813  | -0.058 | —                 |

## 5 axis

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

| Model      | Fc     | k             | Fv     | Fo     | Note              |
|------------|--------|---------------|--------|--------|-------------------|
| Linear (+) | —      | —             | 0.022  | 0.080  | Positive velocity |
| Linear (−) | —      | —             | 0.036  | -0.061 | Negative velocity |
| atan       | 0.045  | 308118984.980 | 0.029  | 0.005  | —                 |
| tanh       | 0.070  | 151.771       | 0.029  | 0.005  | —                 |
| sigmoid    | 0.070  | 260.202       | 0.029  | 0.005  | —                 |

## 6 axis

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

| Model      | Fc     | k             | Fv     | Fo     | Note              |
|------------|--------|---------------|--------|--------|-------------------|
| Linear (+) | —      | —             | 0.094  | 0.089  | Positive velocity |
| Linear (−) | —      | —             | 0.052  | -0.097 | Negative velocity |
| atan       | 0.059  | 377915112.600 | 0.072  | 0.009  | —                 |
| tanh       | 0.093  | 242.287       | 0.072  | 0.009  | —                 |
| sigmoid    | 0.093  | 520.084       | 0.072  | 0.009  | —                 |

## 7 axis

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

| Model      | Fc     | k      | Fv     | Fo     | Note              |
|------------|--------|--------|--------|--------|-------------------|
| Linear (+) | —      | —      | 0.275  | 0.137  | Positive velocity |
| Linear (−) | —      | —      | 0.144  | -0.315 | Negative velocity |
| atan       | 0.232  | 13.234 | 0.069  | -0.058 | —                 |
| tanh       | 0.312  | 7.888  | 0.104  | -0.059 | —                 |
| sigmoid    | 0.312  | 15.776 | 0.104  | -0.059 | —                 |

Closed 2025-05-13.

Thread 104 (2025-05-08):

Pedestal Improvements

pruthakj, 2025-05-08:
**Issue**
During gravity compensation testing, the arm was moved to its frontal limit and returned to its resting position no more than five times. This process produced screeching metal sounds, and the extrusion shifted from its original position, despite the L-brackets remaining intact. However, the screws showed signs of increased tension.

**Location**
At the aluminium extrusion where arm is attached to.

**Images**

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

Closed 2025-05-27.

Thread 111 (2025-05-16):

Incorrect Damiao 4310 Motor Model Leads to Interference Issues in DM4340_TOP_Part_ADJ_J1 Assembly

breadlees, 2025-05-16:
**Component Naming Conflict:**
The model originally named DM4340_TOP_Part_ADJ_J1 in the 3D CAD files (designed for J5 and J7 applications) has been corrected to DM4310_TOP_Part_ADJ_J5-7  to reflect its actual usage context.

**Critical Dimensional Error:**
During manufacturing validation, we identified that the publicly released 3D model of the Damiao DM4310 motor contains a critical dimensional discrepancy:

Observed Value: 6.95mm (motor rotor mounting surface offset)

Specified Value: 6.00mm (per official motor documentation)

**Problem:**
This dimensional deviation directly causes excessive thickness in the DM4310_TOP_Part_ADJ_J5-7 component, resulting in mechanical interference with Link5_A during assembly. The interference occurs because Link5_A must pass through DM4310_TOP_Part_ADJ_J5-7 to interface with the motor rotor's mounting surface - a geometric requirement compromised by the thickened structure.

**Impact:**

Assembly interference preventing proper installation of Link5_A

Potential functional impairment of the motion system

Visual Reference:

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

Proposed Solution:
We have submitted a revised version of DM4340_TOP_Part_ADJ_J5-7 (previously DM4340_TOP_Part_ADJ_J1) incorporating:

Corrected dimensional parameters matching the DM4310 motor specifications

[DM4310_TOP_Part_ADJ_J5-7 v2.step.zip](https://github.com/user-attachments/files/20257418/DM4310_TOP_Part_ADJ_J5-7.v2.step.zip)

We appreciate your open-source help to us.

Closed 2025-07-24.

Thread 113 (2025-05-19):

Can't Find Gripper Model in Onshape

needrepair, 2025-05-19:
I've been exploring the OpenArm project and was looking for the gripper (end-effector) model. I browsed the shared Onshape project, but I couldn't find any CAD or assembly related to the gripper.

Could you kindly point me to where the gripper model is located, if it exists? Or is it planned for future release?

Thanks a lot for your great work!

Closed 2025-05-27.

Thread 114 (2025-05-27):

Applying NVIDIA GR00T N1

yongjounwoo, 2025-05-27:
Hello,

I recently watched your OpenArm YouTube video where you fine-tuned NVIDIA’s GR00T N1 with just 50 teleoperation episodes to perform a pick-and-place task with beverage bottles. I found it incredibly fascinating and impressive.

I’m currently working on applying NVIDIA’s N1 myself, but unfortunately, I haven’t been able to achieve the results I hoped for. I would greatly appreciate any guidance you could offer.

I understand this may not be directly related to your excellent package, but I’m very curious how you managed to successfully complete this task.

If possible, I would be extremely grateful if you could share any insights on the following:

Would it be possible to access the dataset you used for fine-tuning N1?

How did you configure your training parameters for N1 fine-tuning? (e.g., Tune LLM, Tune Diffusion, Tune Visual, number of steps, etc.)

I truly hope to hear back from you. The robot and your work on it look outstanding.

Best regards,

Thread 115 (2025-06-03):

Prepare CI

kou, 2025-06-03:
**Is your feature request related to a problem? Please describe.**

We want to keep our codes workable (at least buildable).

**Describe the solution you'd like**

Add GitHub Actions based CI.

**Describe alternatives you've considered**

No.

**Additional context**

See also: https://github.com/reazon-research/openarm_ros2/issues/17

otegami, 2025-06-05:
We will use the following docker image to use STM32 Cube IDE.
https://hub.docker.com/r/xanderhendriks/stm32cubeide

kou, 2025-07-18:
We don't manage our code in this repository. We use other repositories.

Closed 2025-07-18.

Thread 132 (2025-06-28):

Unable to switch control mode for DAMIAO motor using switchControlMode

SDKBig, 2025-06-28:
I'm currently using the DAMIAO motor and trying to switch its control mode via the `switchControlMode` function. However, the motor consistently fails to switch modes.

Closed 2025-08-06.
