reazon-research/OpenArm/control/canfd_control/Core/Src/main.c

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
/* Includes ------------------------------------------------------------------*/
#include "main.h"
#include "dcmi.h"
#include "fdcan.h"
#include "i2c.h"
#include "octospi.h"
#include "spi.h"
#include "tim.h"
#include "usart.h"
#include "usb_otg.h"
#include "gpio.h"

/* USER CODE BEGIN Includes */
#include "can_bsp.h"
#include "dm_drv.h"
#include <stdio.h>
#include "EventRecorder.h"
/* USER CODE END Includes */

/* USER CODE BEGIN PD */
#define CONTROL_PERIOD_US 1000 // 1kHz control frequency
#define TOGGLE_PERIOD_US 5000000  // 5 seconds in microseconds
OpenArm_t arm;
/* USER CODE END PD */


/* USER CODE BEGIN PV */
extern UART_HandleTypeDef huart2;  // Define the UART handle for USART2
/* USER CODE END PV */

void SystemClock_Config(void);
/* USER CODE BEGIN PFP */
int __io_putchar(int ch)
{
	HAL_UART_Transmit(&huart2,(uint8_t*)&ch,1,HAL_MAX_DELAY);
	return ch;
}

void delay_us(uint32_t us) {
    uint32_t start = __HAL_TIM_GET_COUNTER(&htim2);
    while (__HAL_TIM_GET_COUNTER(&htim2) - start < us);
}
/* USER CODE END PFP */

/**
  * @brief  The application entry point.
  * @retval int
  */
int main(void)
{
  /* USER CODE BEGIN 1 */
	
//01 08 00 00 02 00 00 00
  /* USER CODE END 1 */

  /* MCU Configuration--------------------------------------------------------*/

  /* Reset of all peripherals, Initializes the Flash interface and the Systick. */
  HAL_Init();

  /* Configure the system clock */
  SystemClock_Config();

  /* Initialize all configured peripherals */
  MX_GPIO_Init();
  MX_DCMI_Init();
  MX_FDCAN1_Init();
	MX_FDCAN2_Init();
  MX_FDCAN3_Init();
  MX_I2C1_Init();
  MX_OCTOSPI1_Init();
  MX_SPI1_Init();
  MX_SPI2_Init();
  MX_SPI3_Init();
  MX_TIM1_Init();
  MX_UART7_Init();
  MX_UART9_Init();
  MX_USART1_UART_Init();
  MX_USART2_UART_Init();
  MX_USART3_UART_Init();
  MX_USART10_UART_Init();
  MX_USB_OTG_HS_PCD_Init();
  MX_TIM2_Init();
  /* USER CODE BEGIN 2 */
	oa_gpio_13_on();
	oa_gpio_14_on();
	HAL_Delay(200);
	FDCAN1_Config();
	FDCAN2_Config();
	
	int id[NUM_MOTORS];
	int master_id[NUM_MOTORS];
	float zero[NUM_MOTORS];
	float one[NUM_MOTORS];
	int mode = MIT_MODE;

	int type[8] = {DM4310, DM4310, DM4310, DM4310, DM4310, DM4310, DM4310, DM4310};
	
	for (int i = 0; i < NUM_MOTORS; ++i) {
		id[i] = i + 1; // 0x01 to 0x08
		master_id[i] = 0x10 + (i + 1); // 0x11 to 0x18
		zero[i] = 0.0f;
		one[i] = 1.0f;
	}
	
	//openarm setup
	openarm_init(&arm, id, master_id, mode, type);
	HAL_Delay(1000);
	openarm_enable(&arm, &hfdcan1);
	
	HAL_TIM_Base_Start(&htim2);
	
	// example of writing baudrate
//	for (int i = 0; i < NUM_MOTORS; ++i) {
//		write_baudrate(&hfdcan1, i, BAUD_5M);
//	}
	
	// starting event recorder for debugging purposes
	EventRecorderInitialize(EventRecordAll, 1);
	
	uint32_t toggle_timer = 0;
	uint8_t toggle = 0;
	uint32_t t_schedule = 0;
	__HAL_TIM_SET_COUNTER(&htim2, 0);  // Reset timer to avoid drift
	
  while (1)
  { 

    t_schedule += CONTROL_PERIOD_US;

    int32_t td = t_schedule - __HAL_TIM_GET_COUNTER(&htim2);

    if (td > 0) {
				td += 0xFFFFFFFF; // Account for overflow
        while (__HAL_TIM_GET_COUNTER(&htim2) < t_schedule);  // Wait for the required time
    } else {
        printf("WARNING: Control loop overran by %d us!\n", -td);
    }
		
    toggle_timer += CONTROL_PERIOD_US;

    if (toggle_timer >= TOGGLE_PERIOD_US) {
        toggle ^= 1;
        toggle_timer = 0;
    }

		EventRecord2(0x03, 0x00, 0x00); // example of recording event in event recorder
		
		if (toggle) {
				move_mit_all(&arm, &hfdcan1, zero, zero, zero, zero, one);
		} else {
				move_mit_all(&arm, &hfdcan1, zero, zero, zero, zero, zero);
		}
    /* USER CODE END WHILE */

    /* USER CODE BEGIN 3 */
  }
	
	openarm_disable(&arm, &hfdcan1);
	
  /* USER CODE END 3 */
}

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
