reazon-research/OpenArm/control/canfd_control/STM32H7.ioc

Mcu.UserName=STM32H723VGTx
PA0.Signal=S_TIM2_CH1_ETR
PA1.Signal=OCTOSPIM_P1_IO3
PA10.Signal=USART1_RX
PA11.Signal=USB_OTG_HS_DM
PA12.Signal=USB_OTG_HS_DP
PA13(JTMS/SWDIO).Signal=DEBUG_JTMS-SWDIO
PA14(JTCK/SWCLK).Signal=DEBUG_JTCK-SWCLK
PA15(JTDI).Signal=GPXTI15
PA2.Signal=S_TIM2_CH3
PA3.Signal=OCTOSPIM_P1_IO2
PA4.Signal=DCMI_HSYNC
PA5.Signal=ADCx_INN18
PA6.Signal=DCMI_PIXCLK
PA7.Signal=SPI6_MOSI
PA8.Signal=RCC_MCO_1
PA9.Signal=USART1_TX
PB0.Signal=OCTOSPIM_P1_IO1
PB1.Signal=S_TIM3_CH4
PB10.Signal=I2C2_SCL
PB11.Signal=I2C2_SDA
PB12.Signal=GPIO_Output
PB13.Signal=SPI2_SCK
PB14.Signal=USART3_DE
PB15.Signal=S_TIM12_CH2
PB2.Signal=OCTOSPIM_P1_CLK
PB3(JTDO/TRACESWO).Signal=SPI1_SCK
PB4(NJTRST).Signal=SPI1_MISO
PB5.Signal=FDCAN2_RX
PB6.Signal=FDCAN2_TX
PB7.Signal=DCMI_VSYNC
PB8.Signal=I2C1_SCL
PB9.Signal=I2C1_SDA
PC0.Signal=GPIO_Output
PC1.Signal=SPI2_MOSI
PC10.Signal=SPI3_SCK
PC11.Signal=SPI3_MISO
PC12.Signal=SPI3_MOSI
PC13.Signal=GPIO_Output
PC14-OSC32_IN.Signal=GPIO_Output
PC15-OSC32_OUT.Signal=GPIO_Output
PC2_C.Signal=SPI2_MISO
PC3_C.Signal=GPIO_Output
PC4.Signal=ADCx_INP4
PC5.Signal=GPIO_Output
PC6.Signal=DCMI_D0
PC7.Signal=DCMI_D1
PC8.Signal=DCMI_D2
PC9.Signal=DCMI_D3
PD0.Signal=FDCAN1_RX
PD1.Signal=FDCAN1_TX
PD10.Signal=GPIO_Output
PD11.Signal=OCTOSPIM_P1_IO0
PD12.Signal=FDCAN3_RX
PD13.Signal=FDCAN3_TX
PD14.Signal=UART9_RX
PD15.Signal=UART9_TX
PD2.Signal=UART5_RX
PD3.Signal=DCMI_D5
PD4.Signal=USART2_DE
PD5.Signal=USART2_TX
PD6.Signal=USART2_RX
PD7.Signal=SPI1_MOSI
PD8.Signal=USART3_TX
PD9.Signal=USART3_RX
PE0.Signal=UART8_RX
PE1.Signal=UART8_TX
PE10.Signal=GPXTI10
PE11.Signal=OCTOSPIM_P1_NCS
PE12.Signal=GPXTI12
PE13.Signal=S_TIM1_CH3
PE14.Signal=SPI4_MOSI
PE15.Signal=GPIO_Output
PE2.Signal=USART10_RX
PE3.Signal=USART10_TX
PE4.Signal=DCMI_D4
PE5.Signal=DCMI_D6
PE6.Signal=DCMI_D7
PE7.Signal=UART7_RX
PE8.Signal=UART7_TX
PE9.Signal=S_TIM1_CH1
PH0-OSC_IN.Signal=RCC_OSC_IN
PH1-OSC_OUT.Signal=RCC_OSC_OUT
