reazon-research/OpenArm/control/canfd_control/Core/Inc/gpio.h

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
/* Define to prevent recursive inclusion -------------------------------------*/
#ifndef __GPIO_H__
#define __GPIO_H__

#ifdef __cplusplus
extern "C" {
#endif

/* Includes ------------------------------------------------------------------*/
#include "main.h"

/* USER CODE BEGIN Private defines */
/* TODO: Use more meaningful name for the "gpio_13" part. */
static inline void
oa_gpio_13_on(void)
{
  HAL_GPIO_WritePin(GPIOC, GPIO_PIN_13, GPIO_PIN_SET);
}

/* TODO: Use more meaningful name for the "gpio_14" part. */
static inline void
oa_gpio_14_on(void)
{
  HAL_GPIO_WritePin(GPIOC, GPIO_PIN_14, GPIO_PIN_SET);
}
/* USER CODE END Private defines */

void MX_GPIO_Init(void);

#ifdef __cplusplus
}
#endif
#endif /*__ GPIO_H__ */
