reazon-research/OpenArm/control/canfd_control/User/bsp/adc_bsp.c

#include "adc_bsp.h"
#include "adc.h"

/* adc_dma 数据存储数组*/
uint16_t adc1_dma_value[adc1_samples][adc1_channel];
uint16_t adc2_dma_value[adc2_samples][adc2_channel];

/**
***********************************************************************
* @brief:      adc_bsp_init(void)
* @param:		   void
* @retval:     void
* @details:    ADC硬件使能
***********************************************************************
**/
void adc_bsp_init(void)
{
	HAL_ADC_Start_DMA(&hadc1, (uint32_t *)adc1_dma_value, adc1_length);
//	HAL_ADC_Start_DMA(&hadc2, (uint32_t *)adc2_dma_value, adc2_length);
	
//	HAL_ADCEx_InjectedStart_IT(&hadc1);
//	HAL_ADCEx_InjectedStart_IT(&hadc2);
}
/**
***********************************************************************
* @brief:      HAL_ADCEx_InjectedConvCpltCallback()
* @param[in]:	 hadc  adc句柄
* @retval:     void
* @details:    HAL库的中断回调函数
***********************************************************************
**/
void HAL_ADCEx_InjectedConvCpltCallback(ADC_HandleTypeDef* hadc)
{
//	if(hadc == &hadc1)
//	{
//		adc1_injected_callback();
//	}
//	if(hadc == &hadc2)
//	{
//		adc2_injected_callback();
//	}
}

/**
***********************************************************************
* @brief:      adc1_injected(void)
* @param[in]:	 hadc  adc句柄
* @retval:     void
* @details:    供用户调用的弱函数
***********************************************************************
**/
__weak void adc1_injected_callback(void)
{

}
/**
***********************************************************************
* @brief:      adc2_injected(void)
* @param[in]:	 hadc  adc句柄
* @retval:     void
* @details:    供用户调用的弱函数
***********************************************************************
**/
__weak void adc2_injected_callback(void)
{

}
