reazon-research/OpenArm/(commit log)

2025-01-24 single motor test initial commit
2025-01-24 started developing calibration program
2025-01-27 finished v1 calibration script
2025-01-27 first calibration test working
2025-01-27 saved joint limits for openarm
2025-01-29 back to top
    back to top button
2025-01-29 title change
    openarm: a fully open source robot arm project
2025-02-04 Added SocketCANFD driver
2025-02-06 moved CANFD driver location
2025-02-13 remove single motor test documentation from readme
2025-04-23 CANFD Control (#98)
    * initial port over
    * current: tested with one DM4310 MIT torque control
    * openarm_control class, errors need to be fixed
    * move_mit_all controls all motors using MIT ctrl
    * created enable and disable arm functionality
    * added event recorder and fifo queue check
    * control frequency measuring
    * changed tim2 prescaler
    * tested control frequency - ~1.2KHz with 7 motors
    * gradual increase torque test
    * event vs velocity plot for gradual torque program
    * add 4340 limits
    * reformatting
    * removed unknown character comments
    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
    [event_recorder_save_1.csv]
2025-04-23 Bump ros2_packages with moveit2 support for bimanual grippers
2025-04-25 Update ROS2 packages with updated URDFs (#102)
2025-06-05 CANFD Control: remove needless files under MDK-ARM (#116)
    Remove the following files for license clarification and simplification.
    * Auto-generated files
    * User-specific files
    * Files that are not used by the project
2025-06-09 control: use Apache-2.0 license header for MDK-ARM auto-generated file (#119)
    Use explicit Apache-2.0 license header instead of "see LICENSE".
2025-06-09 CANFD Control: use git submodule for drivers (#120)
    For license clarification and simplification.
    Use STM32CubeH7 v1.11.1.
    The original code referred to this version.
    There is no diff affecting.
    After this fix, we need to do the following to build beforehand.
    git submodule update --init control/canfd_control/vendor/STM32CubeH7
2025-06-09 control: remove needless files (#122)
    `EventRecorderConf.h.base@1.1.0` is automatically generated by uVision.
    `event_recorder_save_1.csv` is just measured data, so does not need to
    be managed by Git.
    ---------
    [event_recorder_save_1.csv]
2025-06-09 control: add README simple description for plotter.py (#123)
    Currently, there is no explanation for plotter.py.
2025-06-18 control: refactor and organize license for stm32h7xx_it.c (#128)
    Remove unnecessary code and add Apache-2.0 license.
    With this fix, this file becomes identical to the auto-generated
    version.
