reazon-research/OpenArm/(notices)

Notices in the files:
control/canfd_control/Core/Src/main.c:
Copyright (c) 2024 STMicroelectronics.
All rights reserved.
This software is licensed under terms that can be found in the LICENSE file
control/canfd_control/Core/Inc/gpio.h:
Copyright 2024 STMicroelectronics.
